TobleMiner/noritake_mn12864k_controller/README.md

Noritake MN12864K VFD controller
================================

The Noritake MN12864K is a 128x64 pixel dot-matrix vacuum fluorescent
display.  
The hardware described in this repository is a controller board allowing
control of the VFD via SPI, I2C or USB and supply from a single 5V supply.
