TobleMiner/noritake_mn12864k_controller/noritake_mn12864k_controller.kicad_pcb

## KiCad design noritake_mn12864k_controller.kicad_pcb (2020-12-07)

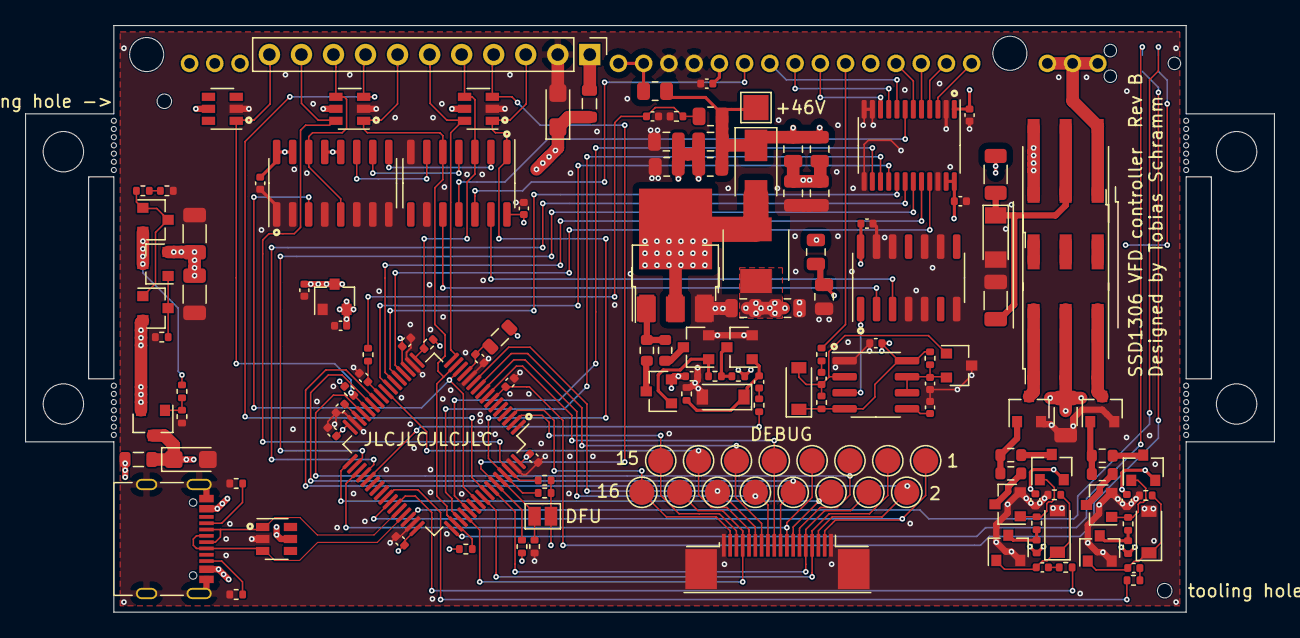
[picture p1: board noritake_mn12864k_controller.kicad_pcb from above]

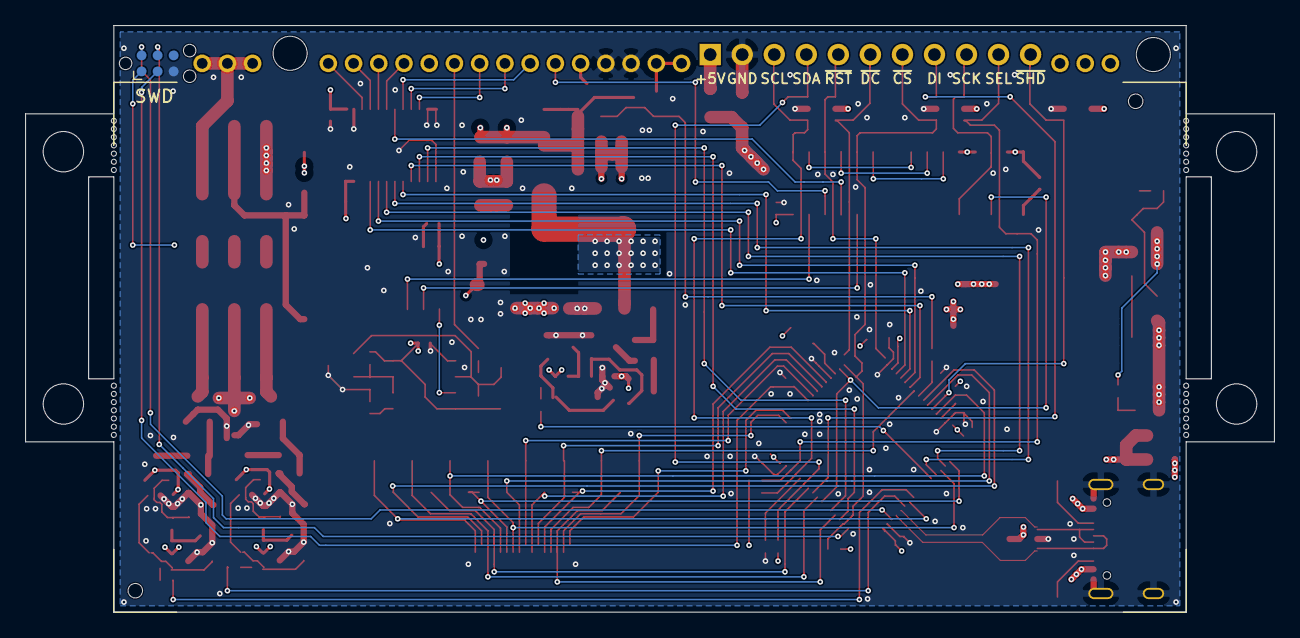
[picture p2: board noritake_mn12864k_controller.kicad_pcb from below]

Board: 4 copper layers, 99.0 x 46.5 mm, 187 parts (3 on the bottom side), 113 nets.

Parts:
C1, C10: 10uF; CP_EIA-3216-12_Kemet-S
C2, C3, C5, C6, C9, C11, C15, C16, C19, C20, C22, C23, C24, C25, C26, C27, C31, C32, C34, C36: 100nF; C_0402_1005Metric
C4, C18, C21, C33, C37: 1uF; C_0402_1005Metric
C7: 10uF; C_1206_3216Metric
C8: 4.7uF; C_1206_3216Metric
C12: 1nF; C_0402_1005Metric
C13, C14: 47uF; C_1206_3216Metric
C17: 4.7uF; C_0402_1005Metric
C28, C29: 10uF LV; C_0805_2012Metric
C30, C35, C38, C39, C40, C41, C42, C43: 10uF; C_0805_2012Metric
D1: 5V6; D_MiniMELF
D2: SS210; D_SMA
D3, D4, D5, D7: B5819W; D_SOD-123
FB1, FB2, FB3: Ferrite_Bead; L_0805_2012Metric
H1, H2: ToolingHole; ToolingHole_JLCSMT
H3, H4: MountingHole; MountingHole_2.7mm_M2.5
H5, H6, H7, H8: MountingHole; MountingHole_3.2mm_M3
H9, H10, H11, H12, H13, H14, H15, H16, H17, H18, H19, H20, H21, H22, H23, H24, H25, H26, H27, H28, H29, H30, H31, H32, H33, H34, H35, H36: Perforation; Perforation_0.4mm
J1: Conn_01x11; PinHeader_1x11_P2.54mm_Vertical
J2: USB_C_Receptacle_USB2.0; USB_C_Receptacle_Palconn_UTC16-G
J3: TagConnect_TC2030_SWD; Tag-Connect_TC2030-IDC-NL_2x03_P1.27mm_Vertical
J4: Conn_01x18; MINTRON-LW05202-18
JP1: DFU; SolderJumper-2_P1.3mm_Open_Pad1.0x1.5mm
L1: 22uH; MWSA0503S
Q1, Q2: AO3400A; SOT-23
Q3, Q6, Q18: S9015; SOT-23
Q4, Q5: AO3401A; SOT-23
Q7, Q9, Q10, Q12, Q15, Q17: 2N7002; SOT-23
Q8, Q11, Q16: LBSS84LT1G; SOT-23
Q13: TO-252; TO-252-3_TabPin2
Q14: CJT04N15; SOT-223-3_TabPin2
R1, R15, R20, R34, R37, R39, R42: 50R; R_0402_1005Metric
R2, R11, R12, R14, R16, R23, R24, R25, R26, R27, R28, R35: 100kR; R_0402_1005Metric
R3, R4, R6, R29: 5.1kR; R_0402_1005Metric
R5: 10kR; R_1206_3216Metric
R7: 22R; R_0805_2012Metric
R8, R9: 33kR; R_0402_1005Metric
R10: 1kR; R_0402_1005Metric
R13: 1MR; R_0402_1005Metric
R17, R18, R21, R22, R40, R41: 33R; R_0603_1608Metric
R19, R36, R38: 470R; R_0402_1005Metric
R30, R31, R32: 100kR; R_0805_2012Metric
R33: 3.3kR; R_0402_1005Metric
T1, T2, T3: Wuerth 760390013; Transformer_Würth_10.05x6.73_6P
T4: Wuerth 760390013; Transformer_Würth_12.60x8.30_6P
TP1: DEBUG00; TestPoint_Pad_D2.0mm
TP2: DEBUG06; TestPoint_Pad_D2.0mm
TP3: DEBUG07; TestPoint_Pad_D2.0mm
TP4: DEBUG08; TestPoint_Pad_D2.0mm
TP5: DEBUG09; TestPoint_Pad_D2.0mm
TP6: DEBUG10; TestPoint_Pad_D2.0mm
TP7: DEBUG11; TestPoint_Pad_D2.0mm
TP8: DEBUG12; TestPoint_Pad_D2.0mm
TP9: DEBUG13; TestPoint_Pad_D2.0mm
TP10: DEBUG14; TestPoint_Pad_D2.0mm
TP11: DEBUG15; TestPoint_Pad_D2.0mm
TP12: DEBUG05; TestPoint_Pad_D2.0mm
TP13: DEBUG01; TestPoint_Pad_D2.0mm
TP14: DEBUG02; TestPoint_Pad_D2.0mm
TP15: DEBUG03; TestPoint_Pad_D2.0mm
TP16: DEBUG04; TestPoint_Pad_D2.0mm
TP17: +48V; TestPoint_Pad_2.0x2.0mm
U1: SN74AVC8T245PW; TSSOP-24_4.4x7.8mm_P0.65mm
U2: 74HC14; SOIC-14_3.9x8.7mm_P1.27mm
U3: CD4051B; SOIC-16_3.9x9.9mm_P1.27mm
U4: MN12864K
U5: STM32F730R8T6; LQFP-64_10x10mm_P0.5mm
U6: NE555D; SOIC-8_3.9x4.9mm_P1.27mm
U7: 74HC08; SOIC-14_3.9x8.7mm_P1.27mm
U8, U10, U11, U12: SRV05-4; SOT-23-6
U9: XC6206PxxxMR; SOT-23

Connections:
+3V3: C5.1, C19.2, C20.2, C21.1, C22.2, C23.2, FB3.2, J3.1, JP1.2, R23.1, R24.1, R25.1, R26.1, R27.1, R28.1, U1.23, U1.24, U5.19, U5.32, U5.48, U5.64, U9.2
+5V: C2.2, C4.2, C6.2, C7.1, C9.1, C11.2, C13.1, C14.1, C18.2, C25.2, C27.2, C28.2, C29.2, C33.2, C37.2, D7.1, L1.1, Q4.2, Q5.2, Q6.2, Q8.2, Q11.2, Q16.2, R13.1, R14.1, R19.1, R36.1, R38.1, T1.5, T2.2, T4.5, U1.1, U2.14, U3.12, U3.13, U3.15, U3.16, U4.16, U6.4, U6.8, U7.14, U9.3, U10.5, U11.5, U12.5
+48V: C35.1, C38.1, C40.1, C42.1, D2.1, R5.1, R7.1, R30.1, R32.1, TP17.1
/4WIRE: J1.4, R26.2, U5.59, U10.3
/CPOL: J1.3, R27.2, U2.1, U5.61, U10.1
/D+: J2.A6, J2.B6, U5.45, U8.3
/D-: J2.A7, J2.B7, U5.44, U8.1
/DBG00: J4.2, TP1.1, U5.42
/DBG01: J4.3, TP13.1, U5.26
/DBG02: J4.4, TP14.1, U5.56
/DBG03: J4.5, TP15.1, U5.58
/DBG04: J4.6, TP16.1, U5.29
/DBG05: J4.7, TP12.1, U5.33
/DBG06: J4.8, TP2.1, U5.35
/DBG07: J4.9, TP3.1, U5.27
/DBG08: J4.10, TP4.1, U5.8
/DBG09: J4.11, TP5.1, U5.9
/DBG10: J4.12, TP6.1, U5.10
/DBG11: J4.13, TP7.1, U5.11
/DBG12: J4.14, TP8.1, U5.24
/DBG13: J4.15, TP9.1, U5.52
/DBG14: J4.16, TP10.1, U5.2
/DBG15: J4.17, TP11.1, U5.3
/IFSEL: J1.10, R25.2, U5.62, U11.6
/MOSI: J1.8, U5.57, U11.3
/SCK: J1.9, U3.5, U3.14, U11.4
/SCK_GATED: U3.3, U5.14, U5.55
/SWCLK: J3.4, U5.49
/SWDIO: J3.2, U5.46
/VBUS_HDR: C1.1, FB1.1, Q3.2, Q4.3, R10.2
/VBUS_USB: C10.1, FB2.1, Q5.3, U8.5
/VCC: FB1.2, J1.1
/VFD/STEPUP_FB: C31.2, R29.2, R32.2, R33.1
/VFD/VFD_GSOUT: R42.2, U4.11
/VFD/sheet60B1BFBD/GBLK_IN: U1.7, U2.11
/VFD/sheet60B1BFBD/GBLK_OUT: U2.12, U4.15
/VFD/sheet60B1BFBE/OUT: Q1.1, R17.1, R18.1
/VFD/sheet60B1BFBF/OUT: Q2.1, R21.1, R22.1
/VFD/sheet6147410A/OUT: Q13.1, Q14.1, R40.1, R41.1
/VFD_BLK: U1.21, U5.20
/VFD_CLK: U1.19, U5.34
/VFD_GCLK: U1.15, U5.51
/VFD_GLAT: U1.16, U5.23
/VFD_GSBLK: U1.17, U5.21
/VFD_GSIN: U1.14, U5.53
/VFD_HTR_G1: R1.2, U5.41
/VFD_HTR_G2: R15.2, U5.43
/VFD_HV_FB: C34.2, R29.1, U5.25
/VFD_HV_G: R34.2, U5.37
/VFD_LAT: U1.20, U5.22
/VFD_SIN: U1.18, U5.36
/~CS: J1.7, R23.2, U2.5, U5.15, U5.50, U11.1
/~DC: J1.6, U5.16, U10.6
/~MCU_RST: C15.2, J3.3, U5.7
/~RST: J1.5, R24.2, U2.3, U5.17, U10.4
/~SHDWN: J1.11, R28.2, U5.28, U12.1
GND: C1.2, C2.1, C4.1, C5.2, C6.1, C7.2, C8.2, C9.2, C10.2, C11.1, C13.2, C14.2, C15.1, C16.1, C17.2, C18.1, C19.1, C20.1, C21.2, C22.1, C23.1, C24.2, C25.1, C26.2, C27.1, C28.1, C29.1, C30.2, C31.1, C33.1, C34.1, C37.1, C39.2, C41.2, C43.2, D1.2, D3.2, D4.2, D5.2, J1.2, J2.A1, J2.A12, J2.B1, J2.B12, J2.S1, J3.5, J4.1, J4.18, J4.MP, Q1.2, Q2.2, Q7.2, Q9.2, Q10.2, Q12.2, Q13.3, Q14.3, Q15.2, Q17.2, Q18.3, R2.2, R3.1, R4.2, R6.2, R9.2, R11.2, R12.2, R16.2, R31.2, R33.2, R35.2, U1.2, U1.11, U1.12, U1.13, U1.22, U2.7, U2.9, U3.1, U3.2, U3.4, U3.6, U3.7, U3.8, U4.17, U4.18, U5.12, U5.18, U5.31, U5.47, U5.63, U6.1, U7.4, U7.5, U7.7, U7.9, U7.10, U7.12, U7.13, U8.2, U9.1, U10.2, U11.2, U12.2
unnamed: C3.1, D3.1, Q7.1, R2.1
unnamed: C3.2, R1.1
unnamed: C8.1, D1.1, R5.2, T1.2, T3.5, T4.2
unnamed: C12.1, D7.2, Q18.1, R13.2, U6.2
unnamed: C12.2, R42.1
unnamed: C16.2, FB3.1, U5.13
unnamed: C17.1, U5.30
unnamed: C24.1, U6.5
unnamed: C26.1, Q18.2, R14.2, U6.6, U6.7
unnamed: C30.1, C35.2, C38.2, C39.1, C40.2, C41.1, C42.2, C43.1, R30.2, R31.1
unnamed: C32.1, D4.1, Q10.1, R16.1
unnamed: C32.2, R15.1
unnamed: C36.1, D5.1, Q15.1, R35.1
unnamed: C36.2, R34.1
unnamed: D2.2, L1.2, Q13.2, Q14.2
unnamed: FB2.2, J2.A4, J2.A9, J2.B4, J2.B9
unnamed: J2.A5, R3.2
unnamed: J2.B5, R4.1
unnamed: JP1.1, R6.1, U5.60
unnamed: Q1.3, T1.6, T2.3, T4.6
unnamed: Q2.3, T1.4, T2.1, T4.4
unnamed: Q3.1, Q3.3, Q6.1, R8.1
unnamed: Q4.1, Q6.3, R12.1
unnamed: Q5.1, R10.1, R11.1
unnamed: Q7.3, R19.2, R20.2
unnamed: Q8.1, Q9.1, R20.1
unnamed: Q8.3, R17.2
unnamed: Q9.3, R18.2
unnamed: Q10.3, R36.2, R37.2
unnamed: Q11.1, Q12.1, R37.1
unnamed: Q11.3, R21.2
unnamed: Q12.3, R22.2
unnamed: Q15.3, R38.2, R39.2
unnamed: Q16.1, Q17.1, R39.1
unnamed: Q16.3, R40.2
unnamed: Q17.3, R41.2
unnamed: R8.2, R9.1
unnamed: T1.1, T3.4, T4.1, U4.1, U4.2, U4.3
unnamed: T1.3, T3.6, T4.3, U4.35, U4.36, U4.37
unnamed: T2.4, T3.3
unnamed: T2.5, T3.2
unnamed: T2.6, T3.1
unnamed: U1.3, U4.6
unnamed: U1.4, U4.7
unnamed: U1.5, U4.8
unnamed: U1.6, U4.9
unnamed: U1.8, U4.14
unnamed: U1.9, U4.13
unnamed: U1.10, U4.12
unnamed: U2.2, U3.9
unnamed: U2.4, U3.10
unnamed: U2.6, U3.11
unnamed: U2.10, U7.2
unnamed: U2.13, U7.3
unnamed: U6.3, U7.1
VDD2: R7.2, U4.19, U4.20
