TobleMiner/noritake_mn12864k_controller/(commit log)

2020-11-14 Connect shutdown and ifsel
    [gate_driver.sch, grid_protection.sch, noritake_mn12864k_controller.sch, noritake_mn12864k_vfd_breakout.sch, power_switch.sch, vfd.sch]
2020-11-14 Add dual filament transformer option
    [noritake_mn12864k_controller.sch, vfd.sch]
2020-11-14 Add PA4/PA5 5V todo
    [noritake_mn12864k_controller.sch]
2020-11-18 Add VFD section
    [gate_driver.sch, grid_protection.sch, noritake_mn12864k_controller.kicad_pcb, noritake_mn12864k_controller.sch, power_switch.sch, vfd.sch]
2020-11-19 Fix grid protection
    Ensure only edges are detected
    [grid_protection.sch, noritake_mn12864k_controller.sch]
2020-11-20 Complete intra section layout
    [gate_driver.sch, grid_protection.sch, noritake_mn12864k_controller.kicad_pcb, noritake_mn12864k_controller.sch, vfd.sch]
2020-11-20 Layout all nets
    [noritake_mn12864k_controller.kicad_pcb]
2020-11-20 Fix FFC courtyard
    [noritake_mn12864k_controller.kicad_pcb]
2020-11-21 Add some via stitching
    [noritake_mn12864k_controller.kicad_pcb]
2020-11-21 Add silkscreen markings
    [noritake_mn12864k_controller.kicad_pcb]
2020-11-21 Add more silkscreen markings
    [noritake_mn12864k_controller.kicad_pcb]
2020-11-21 Add pin 1 indicators
    [noritake_mn12864k_controller.kicad_pcb]
2020-11-21 Add missing LCSC partnumbers
    [gate_driver.sch, noritake_mn12864k_controller.sch]
2020-11-21 Add pin labels
    [noritake_mn12864k_controller.kicad_pcb]
2020-12-05 Fix level shifter
    Level shifter was flipped in scheatic
    Pressed "y" one too many times on that thing :/
    [noritake_mn12864k_controller.kicad_pcb, noritake_mn12864k_controller.sch, vfd.sch]
2020-12-07 Equalize track spacing on debug connector
    [noritake_mn12864k_controller.kicad_pcb]
2020-12-07 Add additional VFD VDD2 bulk capacitance
    [gate_driver.sch, noritake_mn12864k_controller.kicad_pcb, vfd.sch]
2020-12-07 Add additional GND via
    [noritake_mn12864k_controller.kicad_pcb]
2020-12-07 Add more VFD VDD2 bulk capacitance
    [noritake_mn12864k_controller.kicad_pcb, vfd.sch]
2020-12-07 Add optional mounting bracket
    [noritake_mn12864k_controller.kicad_pcb]
2020-12-07 Less diseased power routing
    [noritake_mn12864k_controller.kicad_pcb]
2020-12-07 Add more VFD VDD2 bypassing
    [noritake_mn12864k_controller.kicad_pcb, noritake_mn12864k_controller.sch, vfd.sch]
2020-12-07 Fix accidentially disconnected caps
    [noritake_mn12864k_controller.kicad_pcb, vfd.sch]
2020-12-07 Assign unique value to low voltage 0805 caps
    [noritake_mn12864k_controller.kicad_pcb, vfd.sch]
2020-12-15 Add i2c address select pin
    [gate_driver.sch, noritake_mn12864k_controller.sch]
